JomanaBakria/esp32-white-line-detector-car/README.md

# ESP32 White Stripe Detector Car 🚗⚪

An autonomous **ESP32-based competition robot** that drives a fixed track, detects **white stripes** using reflectance sensors, and adapts its behavior according to the rules.  
The system is optimized to **complete the track as fast as possible** while maintaining reliable detection and accurate stopping.

---

## 🎯 Objectives
- Detect white stripes on the track with **high accuracy**
- Perform actions depending on stripe count:
  - Stop briefly on each of **3 forward stripes**
  - After the 3rd stripe → **switch to reverse**
  - Stop again on the **third backward stripe** only
- Minimize total run time with tuned braking and timing windows

---

## ✨ Features
- **ESP32 DevKit v1** microcontroller
- **2× reflectance sensors (CNY70)** with IR LED illumination
- **4× DC motors** controlled by dual H-Bridge drivers (L293D)
- **Bluetooth control** (start/stop via smartphone)
- **PWM motor control** for speed tuning
- **Active braking pulses** for sharper, faster stops

---

## 🛠️ Hardware Architecture
- **MCU:** ESP32 DevKit v1  
- **Sensors:** 2× CNY70 reflectance sensors + IR LEDs  
- **Motors:** 4× DC motors  
- **Motor Driver:** 2× L293D H-Bridge  
- **Power:** 4× 18650 Li-ion cells + LM7805 regulators  

---

## 📂 Documentation

The following documents provide detailed technical information about the project:

- [📘 מפרט טכני](./docs/מפרט%20טכני.pdf)
- [📊 תרשימי זרימה](./docs/תרשימי%20זרימה.pdf)
- [🔍 תכן מערכת זיהוי פסים](./docs/תכן%20מערכת%20זיהוי%20פסים.pdf)
- [⚙️ תכן מכלול הנעה](./docs/תכן%20מכלול%20הנעה.pdf)
- [🖥️ תכן מכלול בקרה ועיבוד נתונים](./docs/תכן%20מכלול%20בקרה%20ועיבוד%20נתונים.pdf)

---

## 🧩 Control Algorithm
- Forward mode:
  - Drive straight using base PWM
  - Use timed “sampling windows” to reduce false positives
  - On stripe detection → active brake + short pause
  - After 3 stripes → switch to reverse
- Backward mode:
  - Drive back for a fixed window
  - Enable stripe detection
  - On first stripe → brake + pause → stop

---

## 🚀 Getting Started

### Arduino IDE
1. Install **ESP32 Board Support** via Boards Manager  
2. Open the firmware: [`firmware/src/FinalCarCode.ino`](firmware/src/FinalCarCode.ino)  
3. Select your ESP32 board + COM port  
4. Upload the code  
5. Connect via Bluetooth (device name: **RJ CAR**)  
   - Send `1` → Start forward mode  
   - Send `0` → Stop immediately  

---

## 📊 Performance Tuning
- **LINE_PAUSE** → minimum delay that still shows a visible stop  
- **OFF_MS / ON_MS** → shorter windows = less idle time  
- **PWM balance** → adjust motor speeds to keep straight path  
- **Active brake power** → strong enough to stop fast, not to overshoot  

---

## 📷 Media
Here are some pictures of the robot in action:

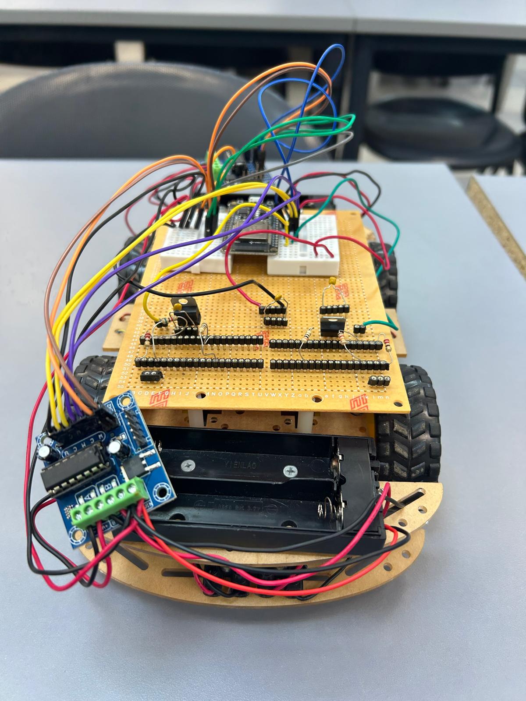
[picture p1: media/image1.jpeg]
Robot Front View

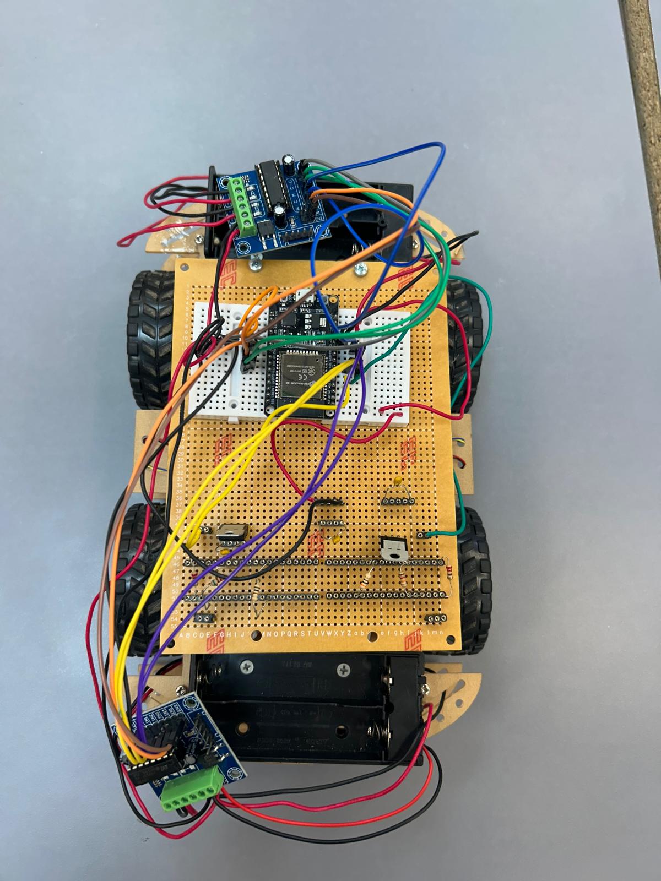
[picture p2: media/image2.jpeg]
Robot Side View


---

## 🎥 Demo Video
You can watch a demo of the robot in action here:  
👉 [Watch the video on Google Drive](https://drive.google.com/file/d/1KyScIxi6h4kys5OYhlDdebKLkKlFJKKN/view?usp=sharing)

---

## 📜 License
This project is released under the [MIT License](LICENSE).
