JomanaBakria/esp32-white-line-detector-car/docs/מפרט טכני.pdf

מפרט טכני :

| | מפרט תפקיד מכלול המערכת
| אספקת מתח לרכיבי המערכת Supply Power | Li-ion 18650 3.6V x 4 Nominal Capacity: 2600mAh Charging Voltage: 4.2 ±0.05 V Nominal Voltage: 3.63 V
Microcontroller | שליטה כוללת על פעולת הרכב עיבוד נתוני החיישנים, הפעלת מנועים, ניהול התקשורת עם האפליקציה. | Esp 32 devkit v1 Operating Voltage: 3.3V Input Voltage: 7-12V IO L : 28 mA IOH:40 mA
| זיהוי פסים לבנים Detector Line | CNY70 × 2 Operating Range: 0-5 mm Input Forward Current: 50ma Wavelength: 950nm
| הנעת מנועי DC בעזרת דוחפי זרם Driver Motor | L293D Motor driver module Supply-Voltage Range: 4.5-36V Output Current: 600 mA
DC Motors | 4 מנועי DC אשר מתחברים ל4- גלגלים להנעת המכונית | DC Motor × 4 Operating Voltage: 4.5-9V Loaded Current: 250 mA max
Voltage Regulator | ויסות וייצוב מתח ממקור ראשי אל מתח 5V | LM7805 × 2 Input Voltage:7.5-25 V Output Voltage: 5V
| שיפור זיהוי פסים לבנים Transmitter Led IR | IR LED × 4 Max forward current :100[mA] Peak Wavelength: 940[nm] Max Forward Voltage:1.2[V]
