JomanaBakria/esp32-white-line-detector-car/docs/תכן מכלול בקרה ועיבוד נתונים.pdf

תכן מכלול בקרה ועיבוד נתונים
מכלול הבקרה מבוסס על מיקרו-בקר 32ESP כאשר תכן זה כולל את כלל המכלולים שפורטו למעלה, וגם כולל יחידת Bluetooth שהיא מובנית בתוך הבקר ולא רכיב נפרד.

הבקר מקבל ומעבד את הנתונים מהחיישנים, ומפעיל את המנועים בהתאם לפקודות התקבלות דרך תקשורת ה Bluetooth-המובנית בו.

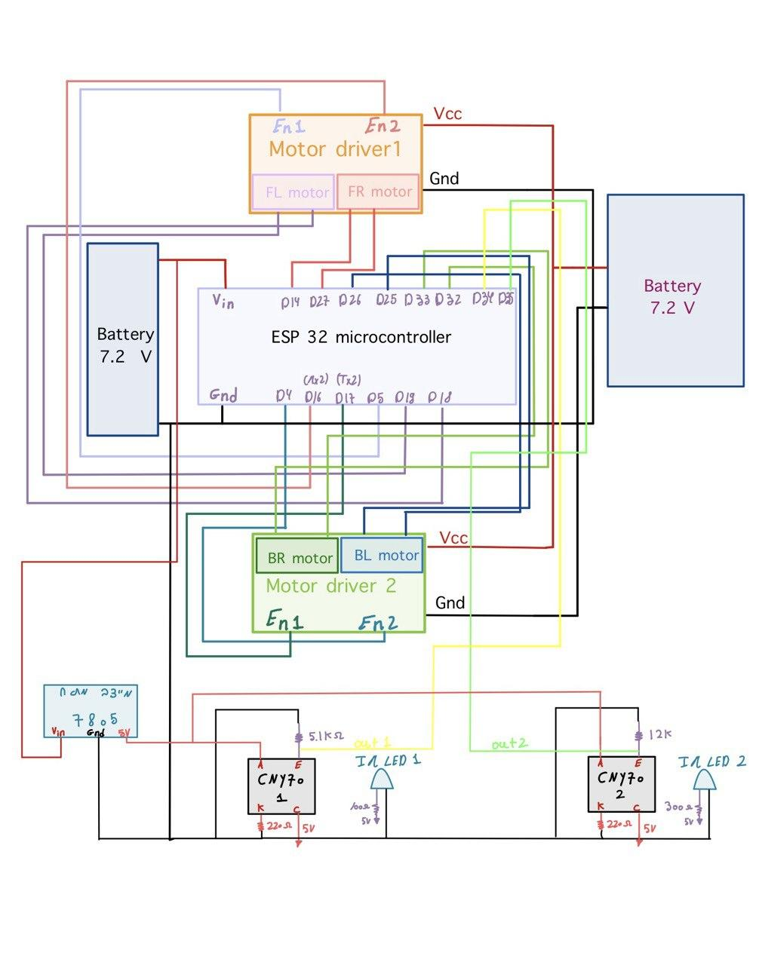
[picture p3: figure]
