JomanaBakria/esp32-white-line-detector-car/docs/תכן מכלול הנעה.pdf

תכן מכלול הנעה
מטרת מכלול ההנעה היא לאפשר את תנועת הרכב במסלול שנקבע. מכלול זה כולל מיקרו-בקר מסוג 32,ESP שני דרייברים מסוג ,D293L מקור מתח וארבעה מנועי DC.
הדרייברים משמשים כדוחפי זרם, ומאפשרים שליטה על כיוון וסיבוב כל אחד מהמנועים תוך אספקת הזרם הדרוש להפעלתם.
הבקר שולח פקודות לדרייברים, אשר בתורם מפעילים את המנועים בהתאם לכיוון ומהירות התנועה הרצויים.
- רשמנו במפרט הטכני את הנתונים IOL/IOH כדי להראות שהזרם של ה ESPלא מספיק לבדו כדי להפעיל מנוע ולכן יש צורך בדוחף הזרם.

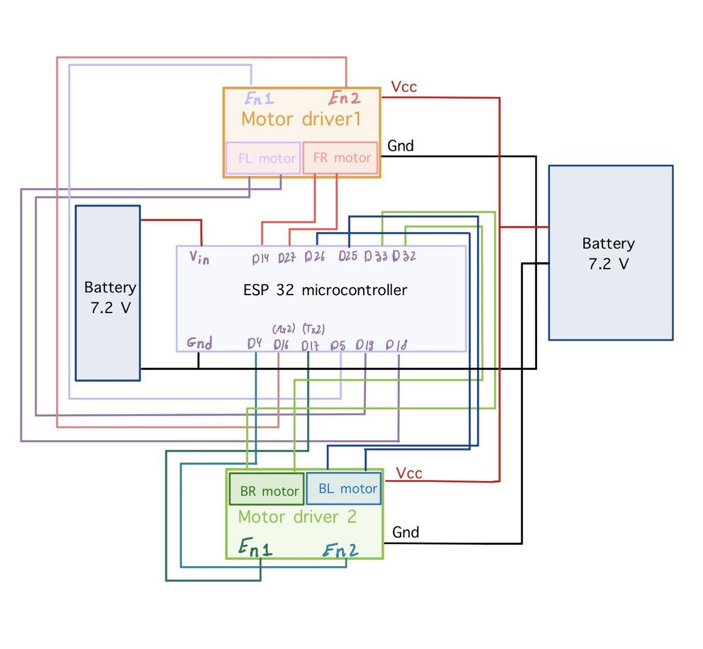
[picture p4: figure]
