JomanaBakria/esp32-white-line-detector-car/docs/תכן מערכת זיהוי פסים.pdf

תכן מערכת זיהוי פסים

תפקיד חיישן האור הוא לזהות שינויים ברמת ההחזר מהמשטח עליו נוסע הרכב, ולהעביר את המידע לבקר 32ESP כאשר החיישן מזהה צבע בהיר , הוא מחזיר ערך גבוה , וכאשר הוא מזהה צבע כהה , הוא מחזיר ערך נמוך.

על גבי שלדת הרכב מותקנים חיישנים מסוג 70CNY הכוללים דיודת פולטת אור אינפרה-אדום (LED IR(המשדרת אור למשטח, וחיישן פוטו דיודה הקולט את ההחזר. האות מהחיישן נמדד על ידי כניסת ADC בבקר, ועוזר לזהות מיקום מדויק של הפסים הלבנים במסלול .

כחלק משיפור יכולת הזיהוי, הוספו לחיישני 70CNY נורות אינפרה-אדום (LEDs IR (נפרדות, המשדרות אור אינפרה-אדום בעוצמה מבוקרת, דבר המאפשר שיפור בהחזר האור ובדיוק הקריאה של הפסים הלבנים, במיוחד בתנאי תאורה משתנים או חלשים .

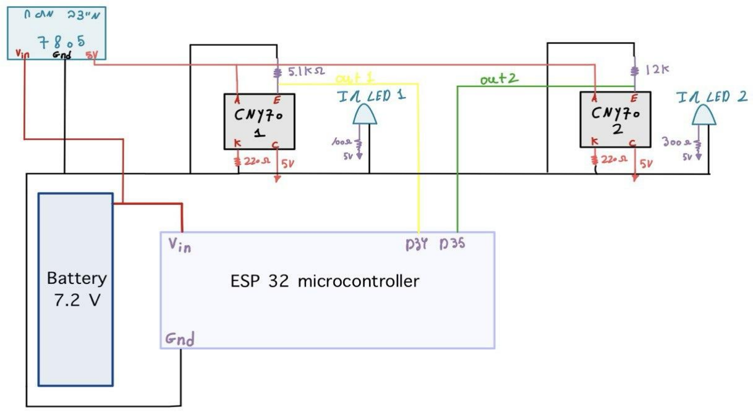
[picture p5: figure]

את וסת המתח 7805LM בחרנו כדי שנוכל לספק לחיישני ה 70CNY מתח עבודה מתאים להם ללא צורך בהוספת מקור מתח נוסף למערכת. לכניסת וסת המתח מגיע מתח של 7.2 וולט משתי סוללות ליתיום וביציאתו מקבלים מתח מיוצב של 5 וולט.

שיקולי בחירת רכיבים:

צריך לבחור נגד עבור הלד אינפרה-אדום שנמצא בתוך חיישן ה70-CNY( DETECTOR ) שיספק זרם בטוח ויעיל. כאשר המתח הקדמי הטיפוסי )TYPICAL )של הדיודה בחיישן הוא V1.25( לפי דף נתונים ( ומתח ההזנה הוא V ,5 נבחר נגד של Ω 220 :

Iled =

VCC − VF

Rled

=

5 − 1. 25
220 = 0. 017A = 17mA

זרם זה מעולה כי הוא נמוך מהזרם מקסימלי המותר )mA 50 ) כמצוין בדף הנתונים .

הספק הצריכה של ה-LED במצב זה יהיה:

Pled = VF × Iled = 1. 25 × 17 = 21. 25mW

ערך זה נמוך משמעותית מהספק המקסימלי המותר ) Mw100), מה שמבטיח פעולה בטוחה לאורך זמן.

הנגדים שחיברנו לאמיטר של חיישני ה- 70CNY נבחרו כך שייצרו הפרש מתחים משמעותי בין מצב של פס לבן לבין מצב של חושך. הפרש זה מבטיח שהמתח על הפין יהיה ברור, וכשהפינים מחוברים ל- ADCשל 32,ESP ההפרש במתח מתורגם לערכים מספריים שונים בטווח 0–.4095 כך המיקרו -בקר יכול להבדיל בבטחה בין פס לבן לחושך, והקריאה האנלוגית נותנת אות יציב ומדויק לכל מצב במסלול.

כאשר הפוטו-טרנזיסטור מוליך )יש החזר אור-<פס לבן(, זרם עובר מקולקטור לאמיטר אל הנגד ואז לאדמה ואז נוצרת נפילת מתח על הנגד, והמתח על הפין יהיה גבוה .

כאשר הפוטו-טרנזיסטור לא מוליך )אין החזר אור מספיק (, זרם כמעט ולא עובר, והמתח על הפין יהיה נמוך .
