JomanaBakria/esp32-white-line-detector-car/docs/תרשימי זרימה.pdf

## תרשימי זרימה

## תרשים זרימה עבור מסלול הלוך

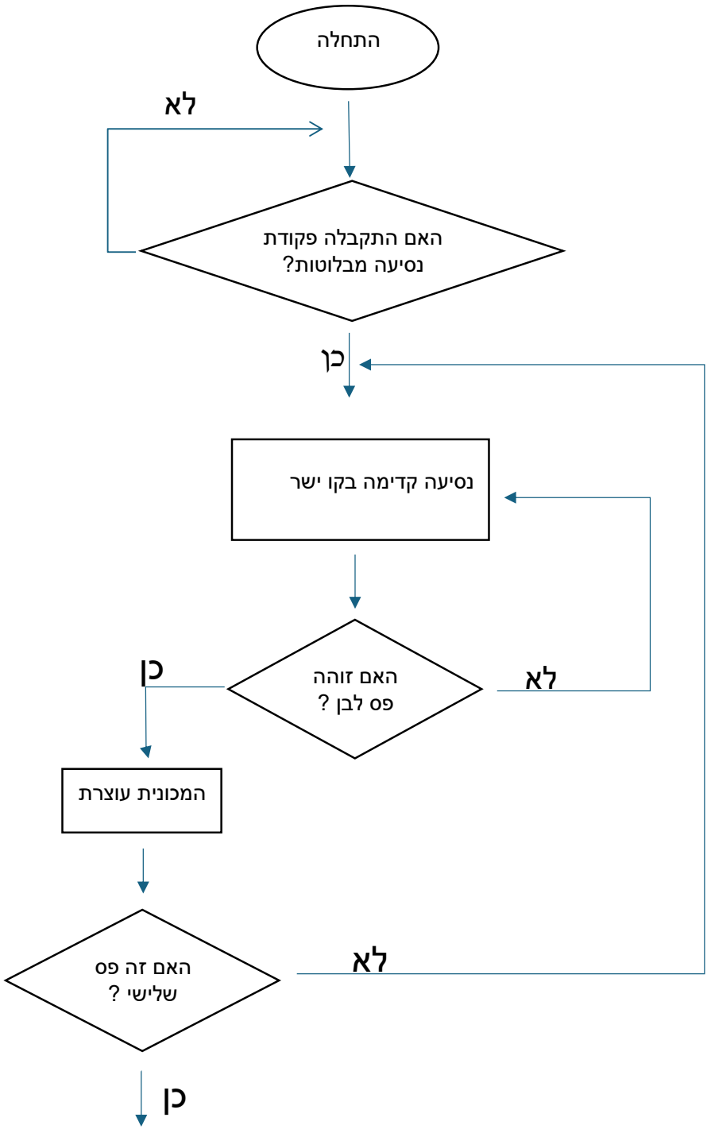
[picture p6: figure]
התחלה; האם התקבלה פקודת נסיעה מבלוטות?; נסיעה קדימה בקו ישר; האם זוהה פס לבן ?; האם זה פס שלישי ?; המכונית עוצרת

מסלול קדמי הסתיים
והמכונית נוסעת אחורה

## תרשים זרימה עבור מסלול אחור

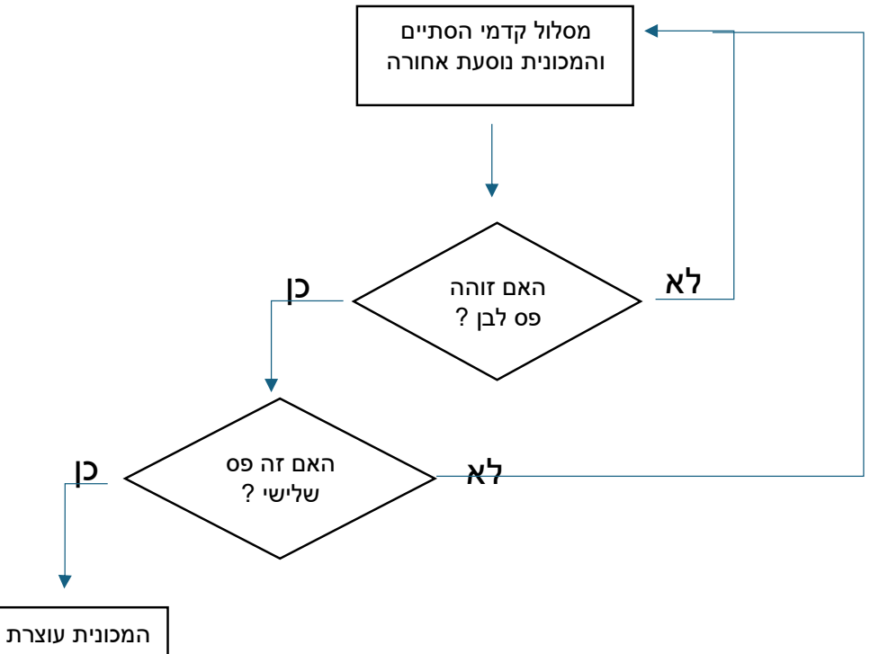
[picture p7: figure]
מסלול קדמי הסתיים והמכונית נוסעת אחורה; האם זוהה פס לבן ?; האם זה פס שלישי ?; המכונית עוצרת

חזרה לנקודת התחלה
ועצירה לפי פקודות בלוטוס

סיום
